j00d3/Asspire/README.md

# Asspire
The "Asspire" is a device by which you can make generative art with your butt! Learn more about the project in the Asspire Developer Guide.
