j00d3/Asspire/parts/mount_plate/mounting_plate.DXF

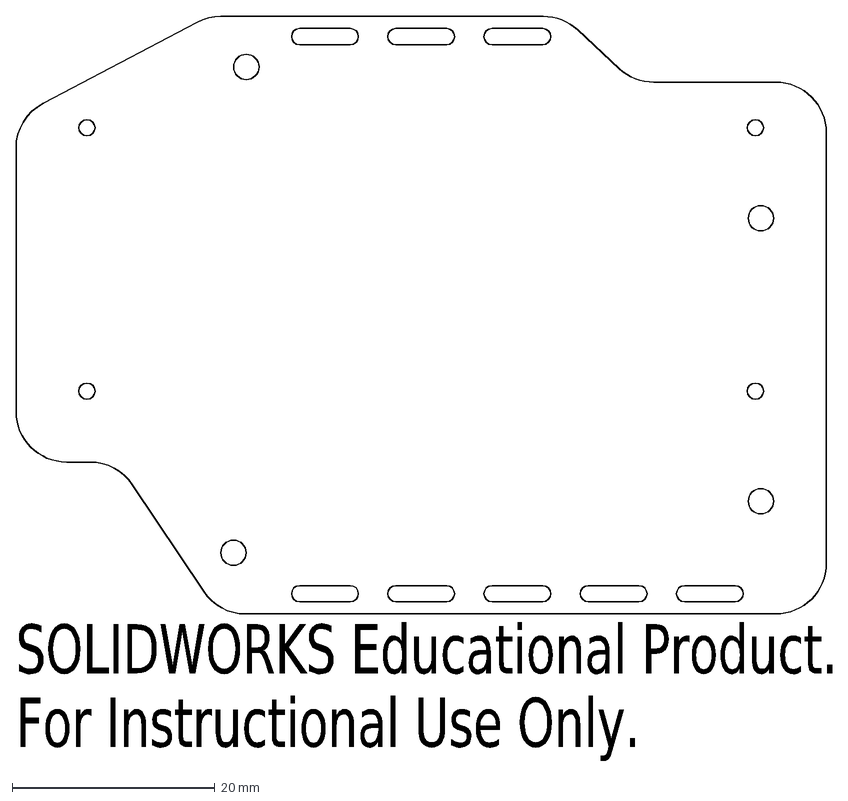
[picture p1: CAD file, 2024-04-29]
parts/mount_plate/mounting_plate.DXF
SOLIDWORKS Educational Product.
For Instructional Use Only.
