j00d3/Asspire/parts/tee_connector/Tee.STEP

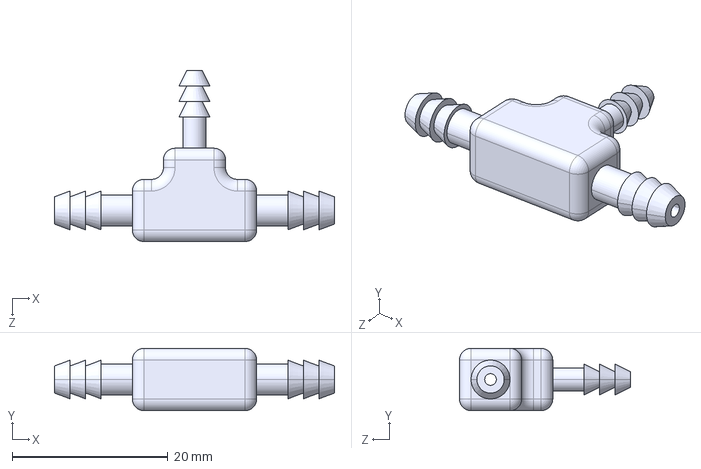
[picture p2: CAD file, 2024-04-29]
parts/tee_connector/Tee.STEP
36.0 x 8.00 x 22.0 mm
