j00d3/Asspire/(list of files, cad)

Other CAD files:
parts/tee_connector/Tee.SLDPRT
parts/tee_connector/Tee.STL
